alt-Anurag/Zeroidea/assets/img/09_jlcpcb_parcel_arrived.jpeg

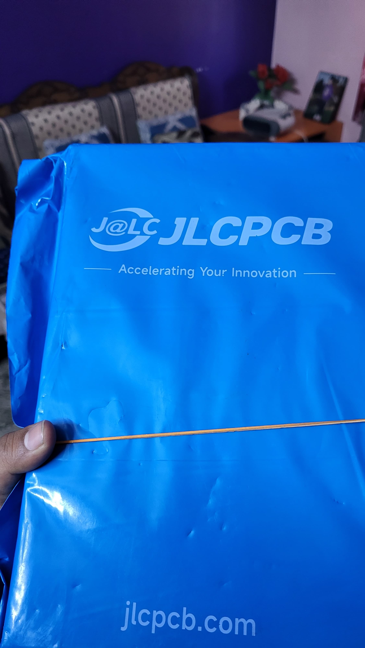
assets/img/09_jlcpcb_parcel_arrived.jpeg
