alt-Anurag/Zeroidea/hardware/schematic/pcb_schematic.kicad_sch

## KiCad design hardware/schematic/pcb_schematic.kicad_sch (2026-09-05)

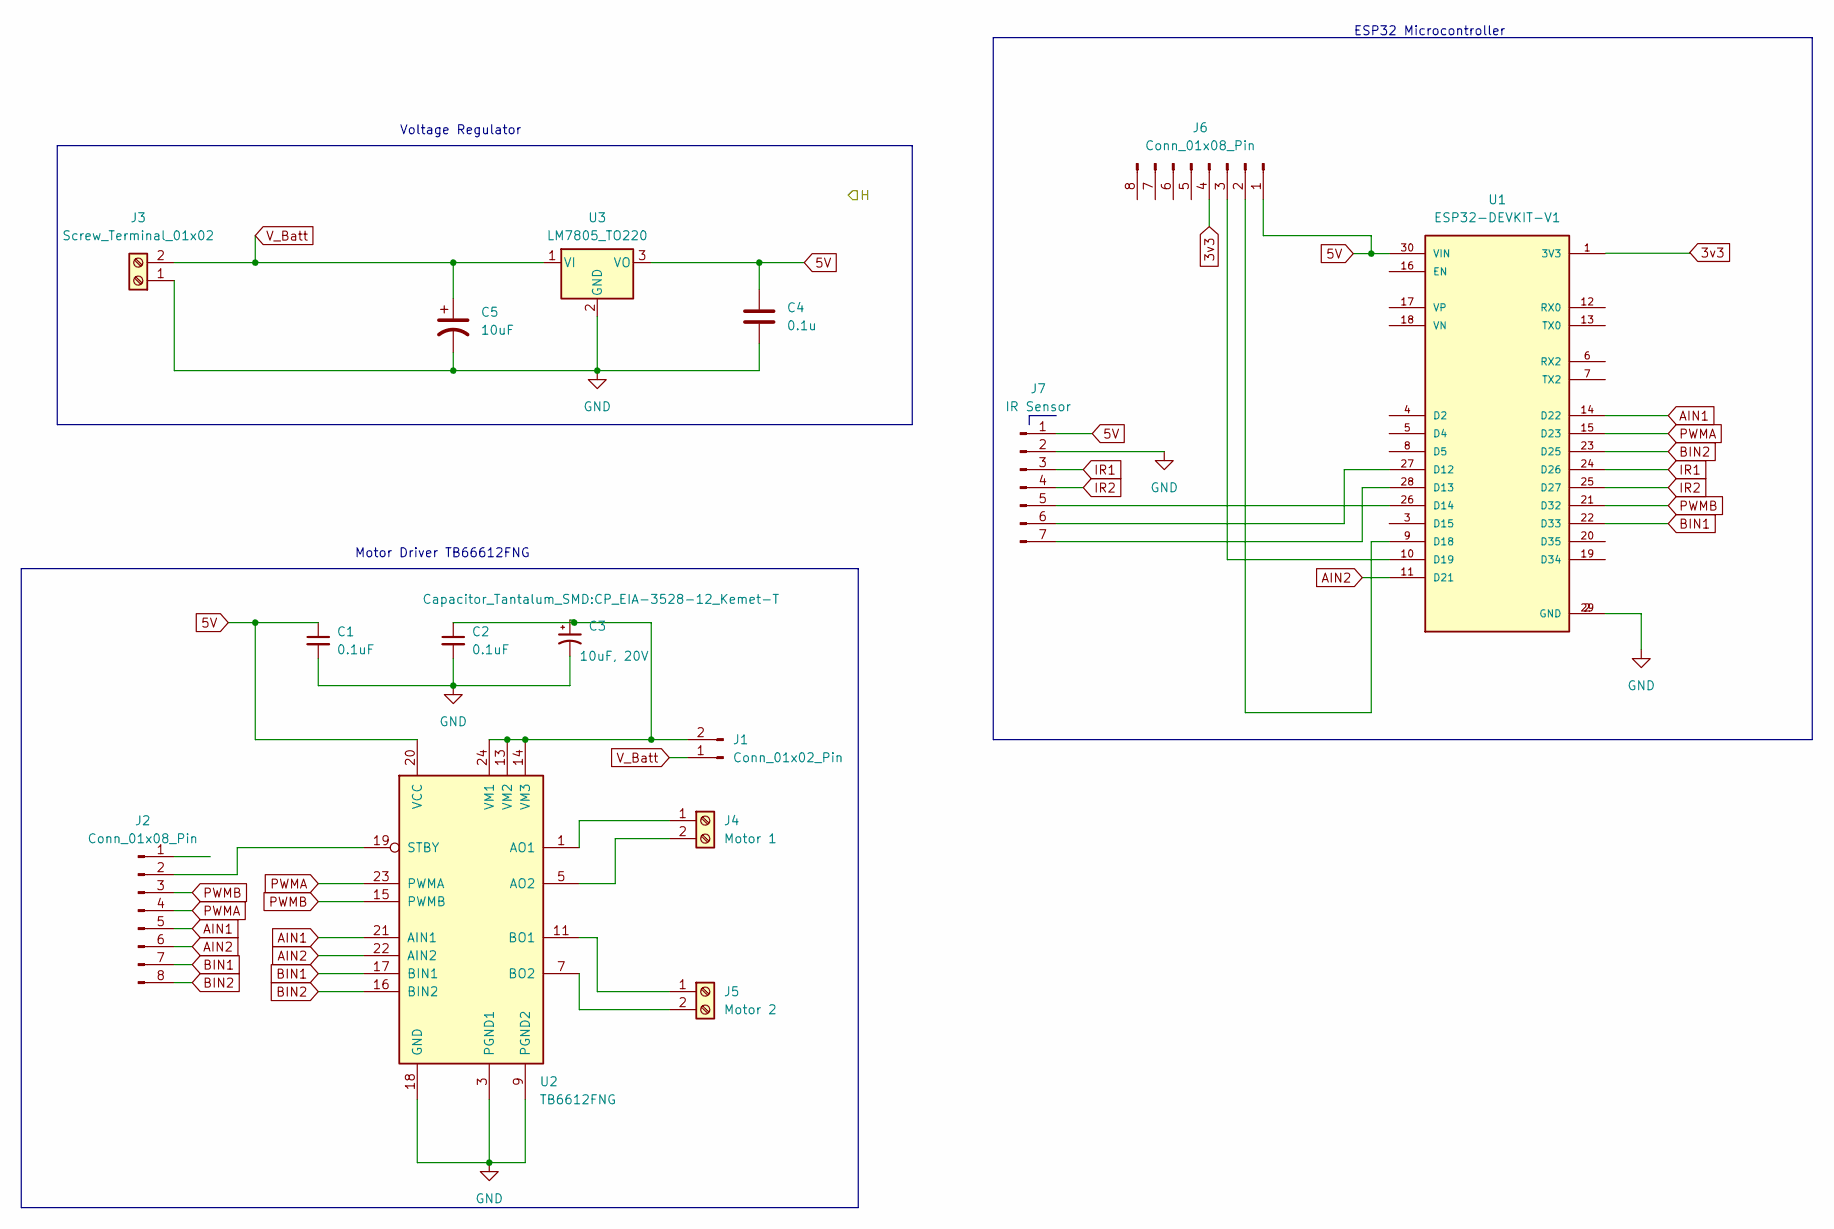
[picture p13: schematic pcb_schematic.kicad_sch]

Parts:
C1, C2: 0.1uF; C_0805_2012Metric
C3: 10uF, 20V; CP_EIA-3528-12_Kemet-T
C4: 0.1u; C_Disc_D3.8mm_W2.6mm_P2.50mm
C5: 10uF; CP_Radial_D4.0mm_P1.50mm
J1: Conn_01x02_Pin; PinHeader_1x02_P1.00mm_Vertical
J2, J6: Conn_01x08_Pin; PinHeader_1x08_P1.00mm_Vertical
J3: Screw_Terminal_01x02; TerminalBlock_Altech_AK300-2_P5.00mm
J4: Motor 1; TerminalBlock_Altech_AK300-2_P5.00mm
J5: Motor 2; TerminalBlock_Altech_AK300-2_P5.00mm
J7: IR Sensor; PinHeader_1x07_P1.00mm_Vertical
U1: ESP32-DEVKIT-V1; MODULE_ESP32_DEVKIT_V1; PARTREV N/A
U2: TB6612FNG; SSOP-24_5.3x8.2mm_P0.65mm
U3: LM7805_TO220; TO-220-3_Vertical

Connections:
3v3: J6.4
5V: C1.1, C4.1, J6.1, J7.1, U1.30 (VIN), U2.20 (VCC), U3.3 (VO)
AIN1: J2.5, U1.14 (D22), U2.21 (AIN1)
AIN2: J2.6, U1.11 (D21), U2.22 (AIN2)
BIN1: J2.7, U1.22 (D33), U2.17 (BIN1)
BIN2: J2.8, U1.23 (D25), U2.16 (BIN2)
GND: C1.2, C2.2, C3.2, C4.2, C5.2, J3.1, J7.2, U1.2 (GND), U1.29 (GND), U2.3 (PGND1), U2.4 (PGND1), U2.9 (PGND2), U2.10 (PGND2), U2.18 (GND), U3.2 (GND)
IR1: J7.3, U1.24 (D26)
IR2: J7.4, U1.25 (D27)
unnamed: C2.1, C3.1, J1.2, U2.13 (VM2), U2.14 (VM3), U2.24 (VM1)
unnamed: J2.2, U2.19 (STBY)
unnamed: J4.1, U2.1 (AO1), U2.2 (AO1)
unnamed: J4.2, U2.5 (AO2), U2.6 (AO2)
unnamed: J5.1, U2.11 (BO1), U2.12 (BO1)
unnamed: J5.2, U2.7 (BO2), U2.8 (BO2)
unnamed: J6.2, U1.9 (D18)
unnamed: J6.3, U1.10 (D19)
unnamed: J7.5, U1.26 (D14)
unnamed: J7.6, U1.27 (D12)
unnamed: J7.7, U1.28 (D13)
PWMA: J2.4, U1.15 (D23), U2.23 (PWMA)
PWMB: J2.3, U1.21 (D32), U2.15 (PWMB)
V_Batt: C5.1, J1.1, J3.2, U3.1 (VI)

Notes on the sheet:
Voltage Regulator
ESP32 Microcontroller
Motor Driver TB66612FNG
