alt-Anurag/Zeroidea/assets/img/06_full_assembly_alt.jpeg

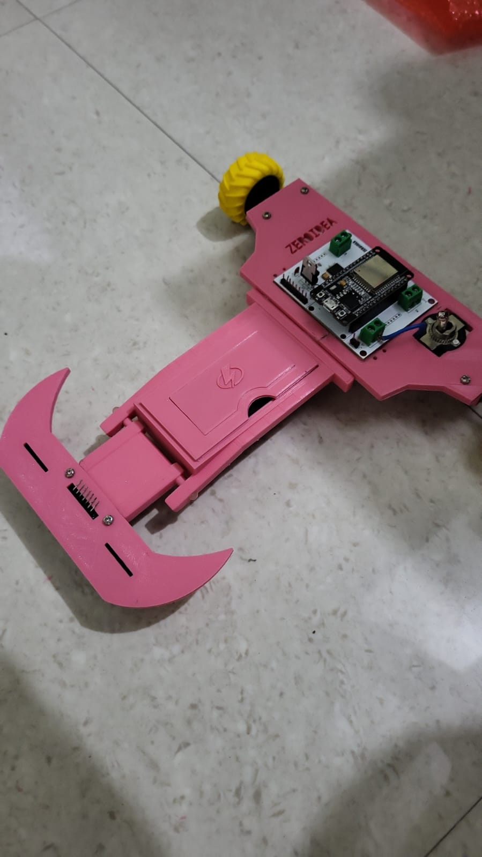
assets/img/06_full_assembly_alt.jpeg
